samdottle/Lionel-Train-remote-control/docs/photos/README.md

# Proto V1.0 Photos

These photos document the completed operational Lionel O27 Controller
Proto V1.0 hardware.

- `Proto_V1.0_operational_front_web.jpg` — optimized primary/front view used by the repository README.
- `Proto_V1.0_operational_angle_web.jpg` — optimized alternate view used by the repository README.

Matched release shown: **UI v1.5 · FW v1.13**.
