samdottle/Lionel-Train-remote-control/firmware/fw_v1_17/CHANGES_v1_17.md

FW v1.17 SG DRAFT, Nov 13 2026. Only change vs v1.16: MAX calibration hard cap (SERVO_MAX_LIMIT_US) raised from 2500 us to 2600 us at Sam's request, because the native pot still had travel at 2500 us (12.4 VAC measured). Many MG90S servos reach their internal stop before 2600 us: if the horn stops turning or the servo hums while nudging MAX, back off. UI v1.8 only updates hint and version text. UNTESTED on hardware. Not approved, not final.
