samdottle/Lionel-Train-remote-control/(commit log)

2026-11-10 Add Proto V1.0 firmware, docs, and project README
    Include the FW v1.13 sketch, wiring notes, changelog, and prototype
    photos without moving the GitHub Pages app. Point the root README at
    the PWA in the repository root and drop links to files that are not
    in this repo.
2026-11-13 UI v1.6 SG DRAFT: add BLE home calibration (pairs with FW v1.15)
2026-11-13 UI v1.7 + FW v1.16: START/MAX calibration (untested)
    Publish UI v1.7 at the repository root, keep UI v1.6 at /v1_6/, bump the service worker cache to o27-v1.7, and add firmware/fw_v1_16/.
